thunderbikes/kicad_cntrl_board/img/hv.png

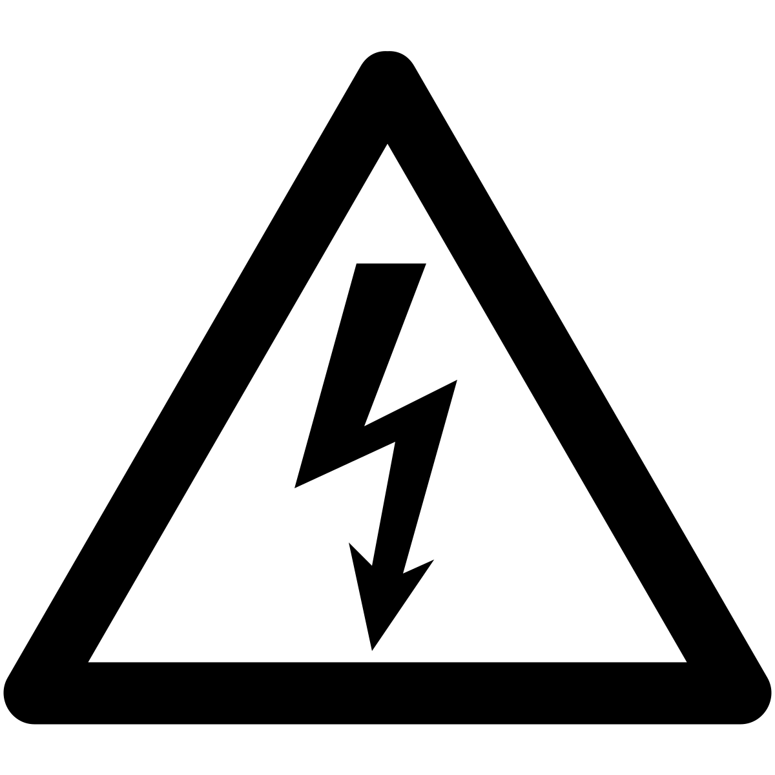
img/hv.png
