thunderbikes/kicad_cntrl_board/main_relay_board.kicad_pcb

## KiCad design main_relay_board.kicad_pcb (2024-07-14)

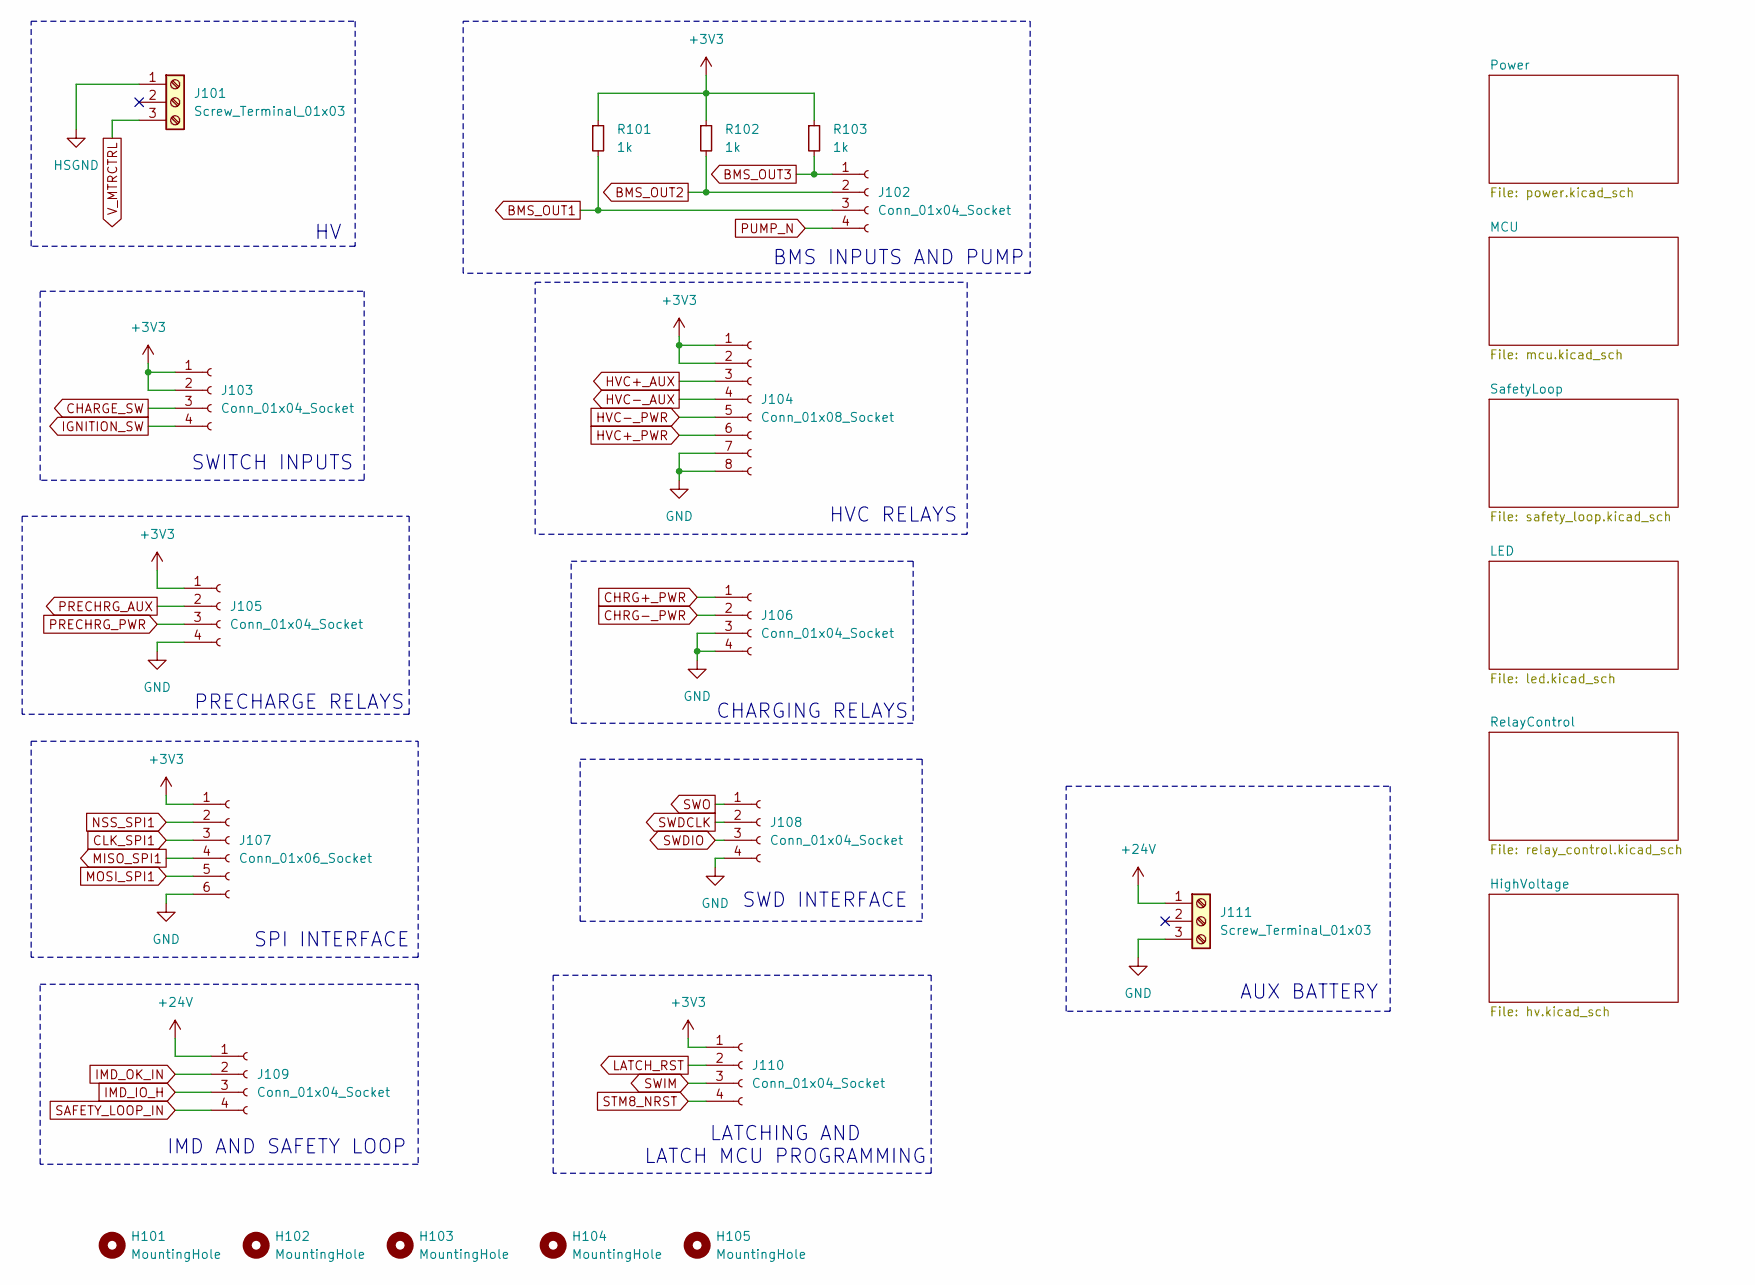
[picture p10: schematic main_relay_board.kicad_sch, Relay Control Board]

Parts:
H101, H102, H103, H104, H105: MountingHole; MountingHole_3mm
J101, J111: Screw_Terminal_01x03; TerminalBlock_Phoenix_MKDS-1,5-3-5.08_1x03_P5.08mm_Horizont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
J102, J103, J105, J106, J108, J109, J110: Conn_01x04_Socket; Molex_Mini-Fit_Jr_5566-04A_2x02_P4.20mm_Vertical
J104: Conn_01x08_Socket; Molex_Mini-Fit_Jr_5566-08A_2x04_P4.20mm_Vertical
J107: Conn_01x06_Socket; Molex_Mini-Fit_Jr_5566-06A_2x03_P4.20mm_Vertical
R101, R102, R103: 1k; R_0603_1608Metric; LCSC C22548

Connections:
+3V3: J103.1, J103.2, J104.1, J104.2, J105.1, J107.1, J110.1, R101.1, R102.1, R103.1; also elsewhere on the board
+24V: J109.1, J111.1; also elsewhere on the board
BMS_OUT1: J102.3, R101.2; also elsewhere on the board
BMS_OUT2: J102.2, R102.2; also elsewhere on the board
BMS_OUT3: J102.1, R103.2; also elsewhere on the board
CHARGE_SW: J103.3; also elsewhere on the board
CHRG+_PWR: J106.1; also elsewhere on the board
CHRG-_PWR: J106.2; also elsewhere on the board
CLK_SPI1: J107.3; also elsewhere on the board
GND: J104.7, J104.8, J105.4, J106.3, J106.4, J107.6, J108.4, J111.3; also elsewhere on the board
HSGND: J101.1; also elsewhere on the board
HVC+_AUX: J104.3; also elsewhere on the board
HVC+_PWR: J104.6; also elsewhere on the board
HVC-_AUX: J104.4; also elsewhere on the board
HVC-_PWR: J104.5; also elsewhere on the board
IGNITION_SW: J103.4; also elsewhere on the board
IMD_IO_H: J109.3; also elsewhere on the board
IMD_OK_IN: J109.2; also elsewhere on the board
LATCH_RST: J110.2; also elsewhere on the board
MISO_SPI1: J107.4; also elsewhere on the board
MOSI_SPI1: J107.5; also elsewhere on the board
NSS_SPI1: J107.2; also elsewhere on the board
PRECHRG_AUX: J105.2; also elsewhere on the board
PRECHRG_PWR: J105.3; also elsewhere on the board
PUMP_N: J102.4; also elsewhere on the board
SAFETY_LOOP_IN: J109.4; also elsewhere on the board
STM8_NRST: J110.4; also elsewhere on the board
SWDCLK: J108.2; also elsewhere on the board
SWDIO: J108.3; also elsewhere on the board
SWIM: J110.3; also elsewhere on the board
SWO: J108.1; also elsewhere on the board
V_MTRCTRL: J101.3; also elsewhere on the board

Notes on the sheet:
PRECHARGE RELAYS
BMS INPUTS AND PUMP
AUX BATTERY
CHARGING RELAYS
IMD AND SAFETY LOOP
SWD INTERFACE
SWITCH INPUTS
SPI INTERFACE
LATCHING AND LATCH MCU PROGRAMMING
HVC RELAYS

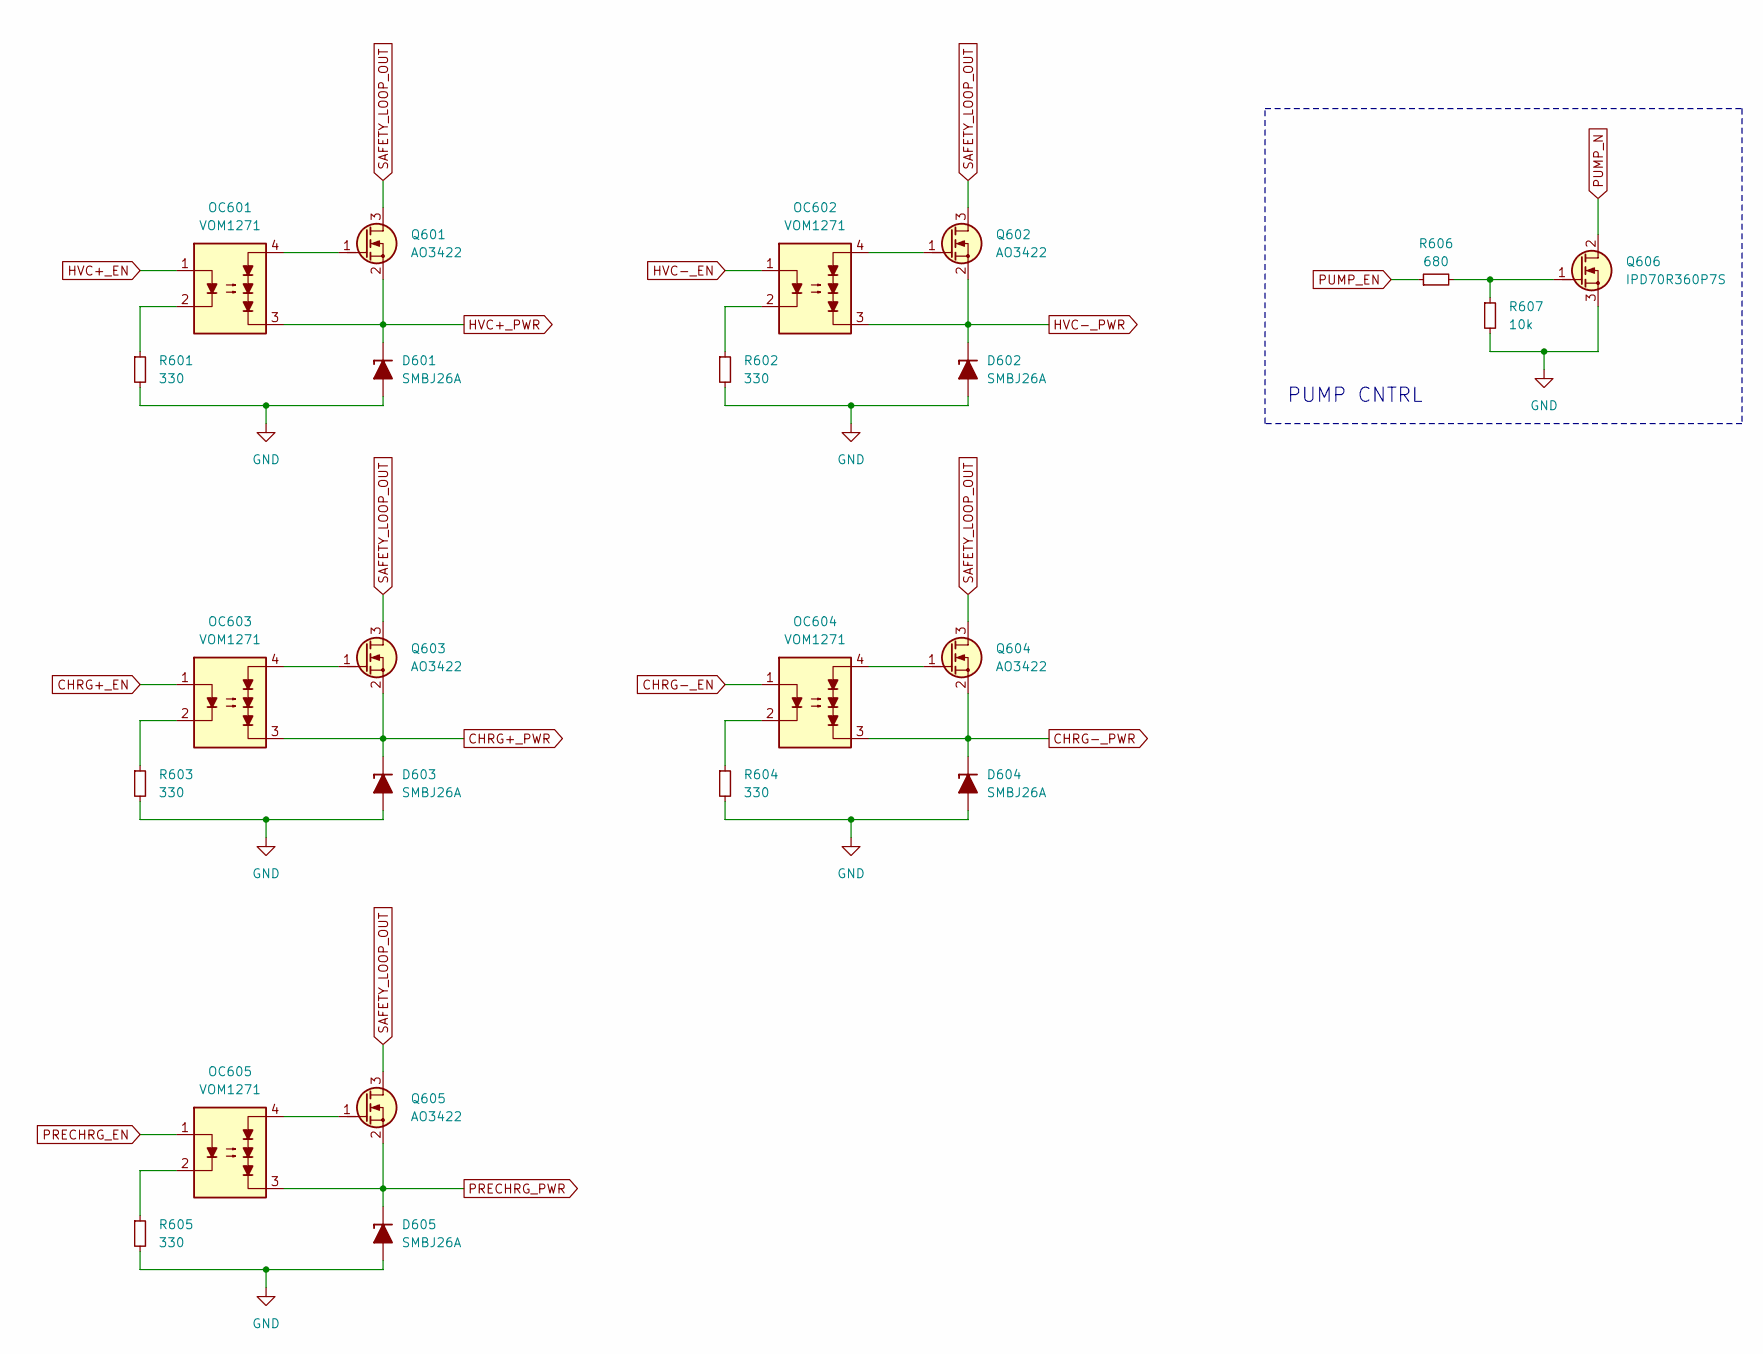
[picture p11: schematic relay_control.kicad_sch, Relay Control Board]

Parts:
D601, D602, D603, D604, D605: SMBJ26A; D_SMB; LCSC C2918418
OC601, OC602, OC603, OC604, OC605: VOM1271; SOIC254P695X242-4N; LCSC C146286
Q601, Q602, Q603, Q604, Q605: AO3422; SOT-23; LCSC C37130
Q606: IPD70R360P7S; TO-252-2; LCSC C151509
R601, R602, R603, R604, R605: 330; R_0603_1608Metric; LCSC C25804
R606: 680; R_0603_1608Metric; LCSC C23228
R607: 10k; R_0603_1608Metric; LCSC C25804

Connections:
CHRG+_EN: OC603.1; also elsewhere on the board
CHRG+_PWR: D603.1 (K), OC603.3, Q603.2 (S); also elsewhere on the board
CHRG-_EN: OC604.1; also elsewhere on the board
CHRG-_PWR: D604.1 (K), OC604.3, Q604.2 (S); also elsewhere on the board
GND: D601.2 (A), D602.2 (A), D603.2 (A), D604.2 (A), D605.2 (A), Q606.3 (S), R601.2, R602.2, R603.2, R604.2, R605.2, R607.2; also elsewhere on the board
HVC+_EN: OC601.1; also elsewhere on the board
HVC+_PWR: D601.1 (K), OC601.3, Q601.2 (S); also elsewhere on the board
HVC-_EN: OC602.1; also elsewhere on the board
HVC-_PWR: D602.1 (K), OC602.3, Q602.2 (S); also elsewhere on the board
unnamed: OC601.2, R601.1
unnamed: OC602.2, R602.1
unnamed: OC603.2, R603.1
unnamed: OC604.2, R604.1
unnamed: OC605.2, R605.1
unnamed: OC601.4, Q601.1 (G)
unnamed: OC602.4, Q602.1 (G)
unnamed: OC603.4, Q603.1 (G)
unnamed: OC604.4, Q604.1 (G)
unnamed: OC605.4, Q605.1 (G)
unnamed: Q606.1 (G), R606.2, R607.1
PRECHRG_EN: OC605.1; also elsewhere on the board
PRECHRG_PWR: D605.1 (K), OC605.3, Q605.2 (S); also elsewhere on the board
PUMP_EN: R606.1; also elsewhere on the board
PUMP_N: Q606.2 (D); also elsewhere on the board
SAFETY_LOOP_OUT: Q601.3 (D), Q602.3 (D), Q603.3 (D), Q604.3 (D), Q605.3 (D); also elsewhere on the board

Notes on the sheet:
PUMP CNTRL

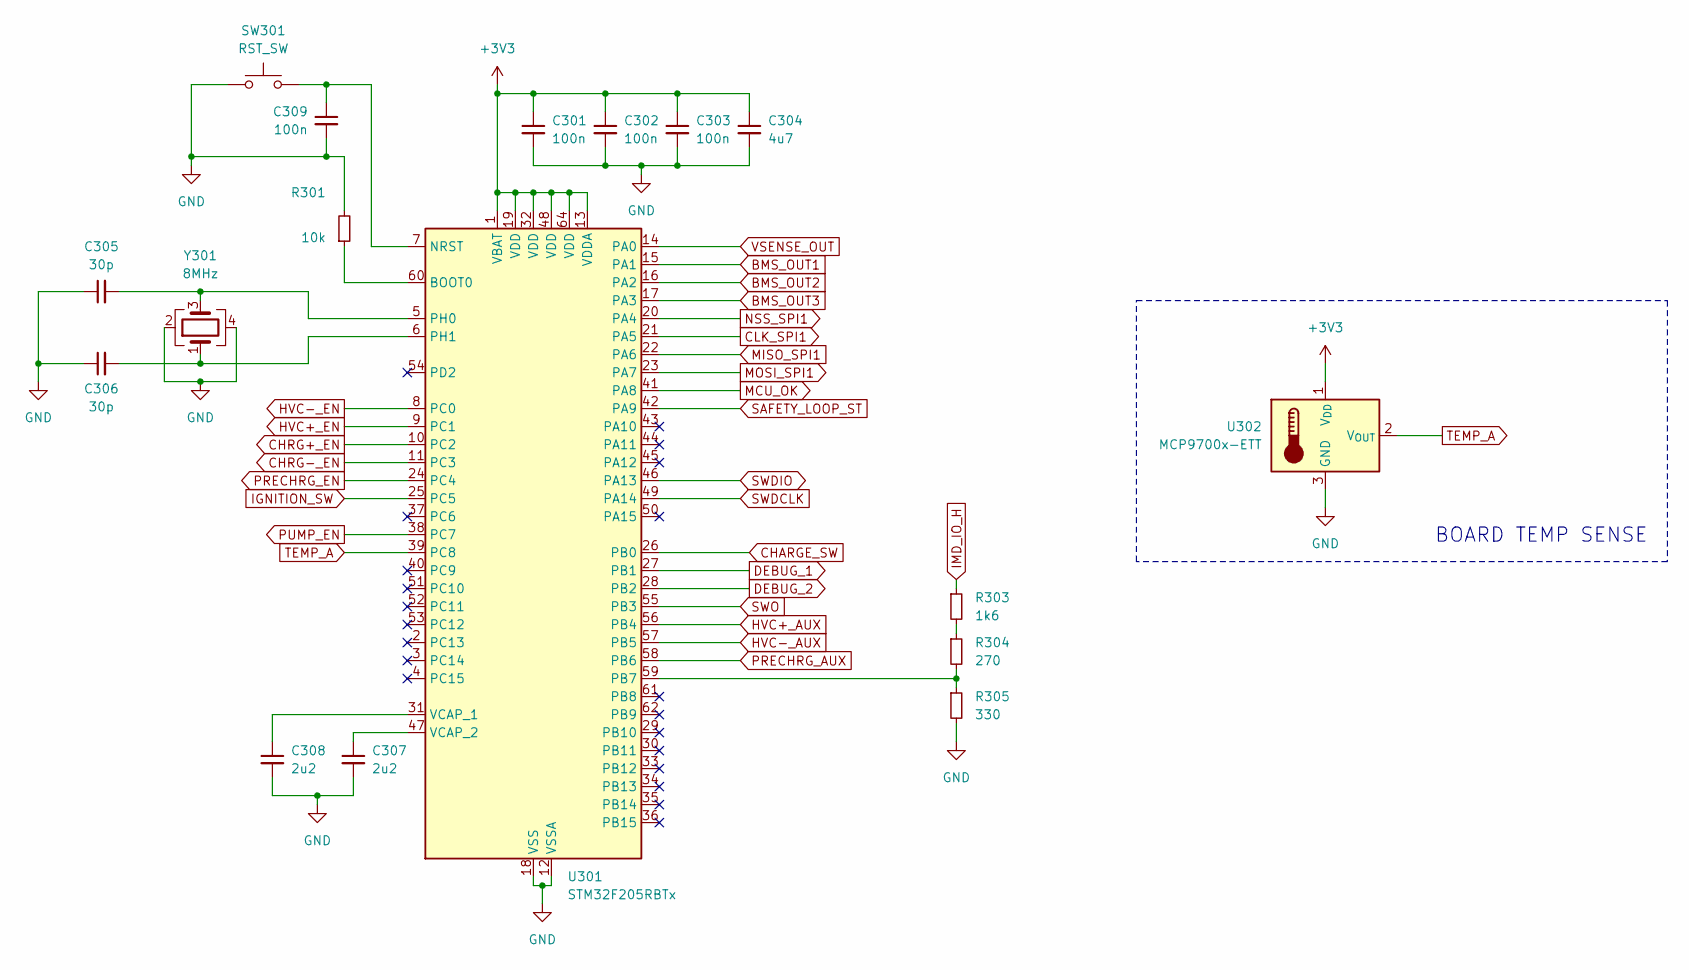
[picture p12: schematic mcu.kicad_sch, Relay Control Board]

Parts:
C301, C302, C303, C309: 100n; C_0603_1608Metric; LCSC C1591
C304: 4u7; C_0603_1608Metric; LCSC C108342
C305, C306: 30p; C_0603_1608Metric; LCSC C1853723
C307, C308: 2u2; C_0603_1608Metric; LCSC C99228
R301: 10k; R_0603_1608Metric; LCSC C25804
R303: 1k6; R_0603_1608Metric; LCSC C22847
R304: 270; R_0603_1608Metric; LCSC C22966
R305: 330; R_0603_1608Metric; LCSC C105881
SW301: RST_SW; SW_Tactile_SPST_NO_Straight_CK_PTS636Sx25SMTRLFS; LCSC C318938
U301: STM32F205RBTx; LQFP-64_10x10mm_P0.5mm; LCSC C8364
U302: MCP9700x-ETT; SOT-23; LCSC C127949
Y301: 8MHz; Crystal_SMD_3225-4Pin_3.2x2.5mm; LCSC C2682775

Connections:
+3V3: C301.1, C302.1, C303.1, C304.1, U301.1 (VBAT), U301.13 (VDDA), U301.19 (VDD), U301.32 (VDD), U301.48 (VDD), U301.64 (VDD), U302.1 (V_{DD}); also elsewhere on the board
BMS_OUT1: U301.15 (PA1); also elsewhere on the board
BMS_OUT2: U301.16 (PA2); also elsewhere on the board
BMS_OUT3: U301.17 (PA3); also elsewhere on the board
CHARGE_SW: U301.26 (PB0); also elsewhere on the board
CHRG+_EN: U301.10 (PC2); also elsewhere on the board
CHRG-_EN: U301.11 (PC3); also elsewhere on the board
CLK_SPI1: U301.21 (PA5); also elsewhere on the board
DEBUG_1: U301.27 (PB1); also elsewhere on the board
DEBUG_2: U301.28 (PB2); also elsewhere on the board
GND: C301.2, C302.2, C303.2, C304.2, C305.1, C306.1, C307.2, C308.2, C309.2, R301.2, R305.2, SW301.1, U301.12 (VSSA), U301.18 (VSS), U301.63 (VSS), U302.3 (GND), Y301.2, Y301.4; also elsewhere on the board
HVC+_AUX: U301.56 (PB4); also elsewhere on the board
HVC+_EN: U301.9 (PC1); also elsewhere on the board
HVC-_AUX: U301.57 (PB5); also elsewhere on the board
HVC-_EN: U301.8 (PC0); also elsewhere on the board
IGNITION_SW: U301.25 (PC5); also elsewhere on the board
IMD_IO_H: R303.1; also elsewhere on the board
MCU_OK: U301.41 (PA8); also elsewhere on the board
MISO_SPI1: U301.22 (PA6); also elsewhere on the board
MOSI_SPI1: U301.23 (PA7); also elsewhere on the board
NSS_SPI1: U301.20 (PA4); also elsewhere on the board
unnamed: R303.2, R304.1
unnamed: R301.1, U301.60 (BOOT0)
unnamed: C309.1, SW301.2, U301.7 (NRST)
unnamed: R304.2, R305.1, U301.59 (PB7)
unnamed: C305.2, U301.5 (PH0), Y301.3
unnamed: C306.2, U301.6 (PH1), Y301.1
unnamed: C308.1, U301.31 (VCAP_1)
unnamed: C307.1, U301.47 (VCAP_2)
PRECHRG_AUX: U301.58 (PB6); also elsewhere on the board
PRECHRG_EN: U301.24 (PC4); also elsewhere on the board
PUMP_EN: U301.38 (PC7); also elsewhere on the board
SAFETY_LOOP_ST: U301.42 (PA9); also elsewhere on the board
SWDCLK: U301.49 (PA14); also elsewhere on the board
SWDIO: U301.46 (PA13); also elsewhere on the board
SWO: U301.55 (PB3); also elsewhere on the board
TEMP_A: U301.39 (PC8), U302.2 (V_{OUT})
VSENSE_OUT: U301.14 (PA0); also elsewhere on the board

Notes on the sheet:
BOARD TEMP SENSE

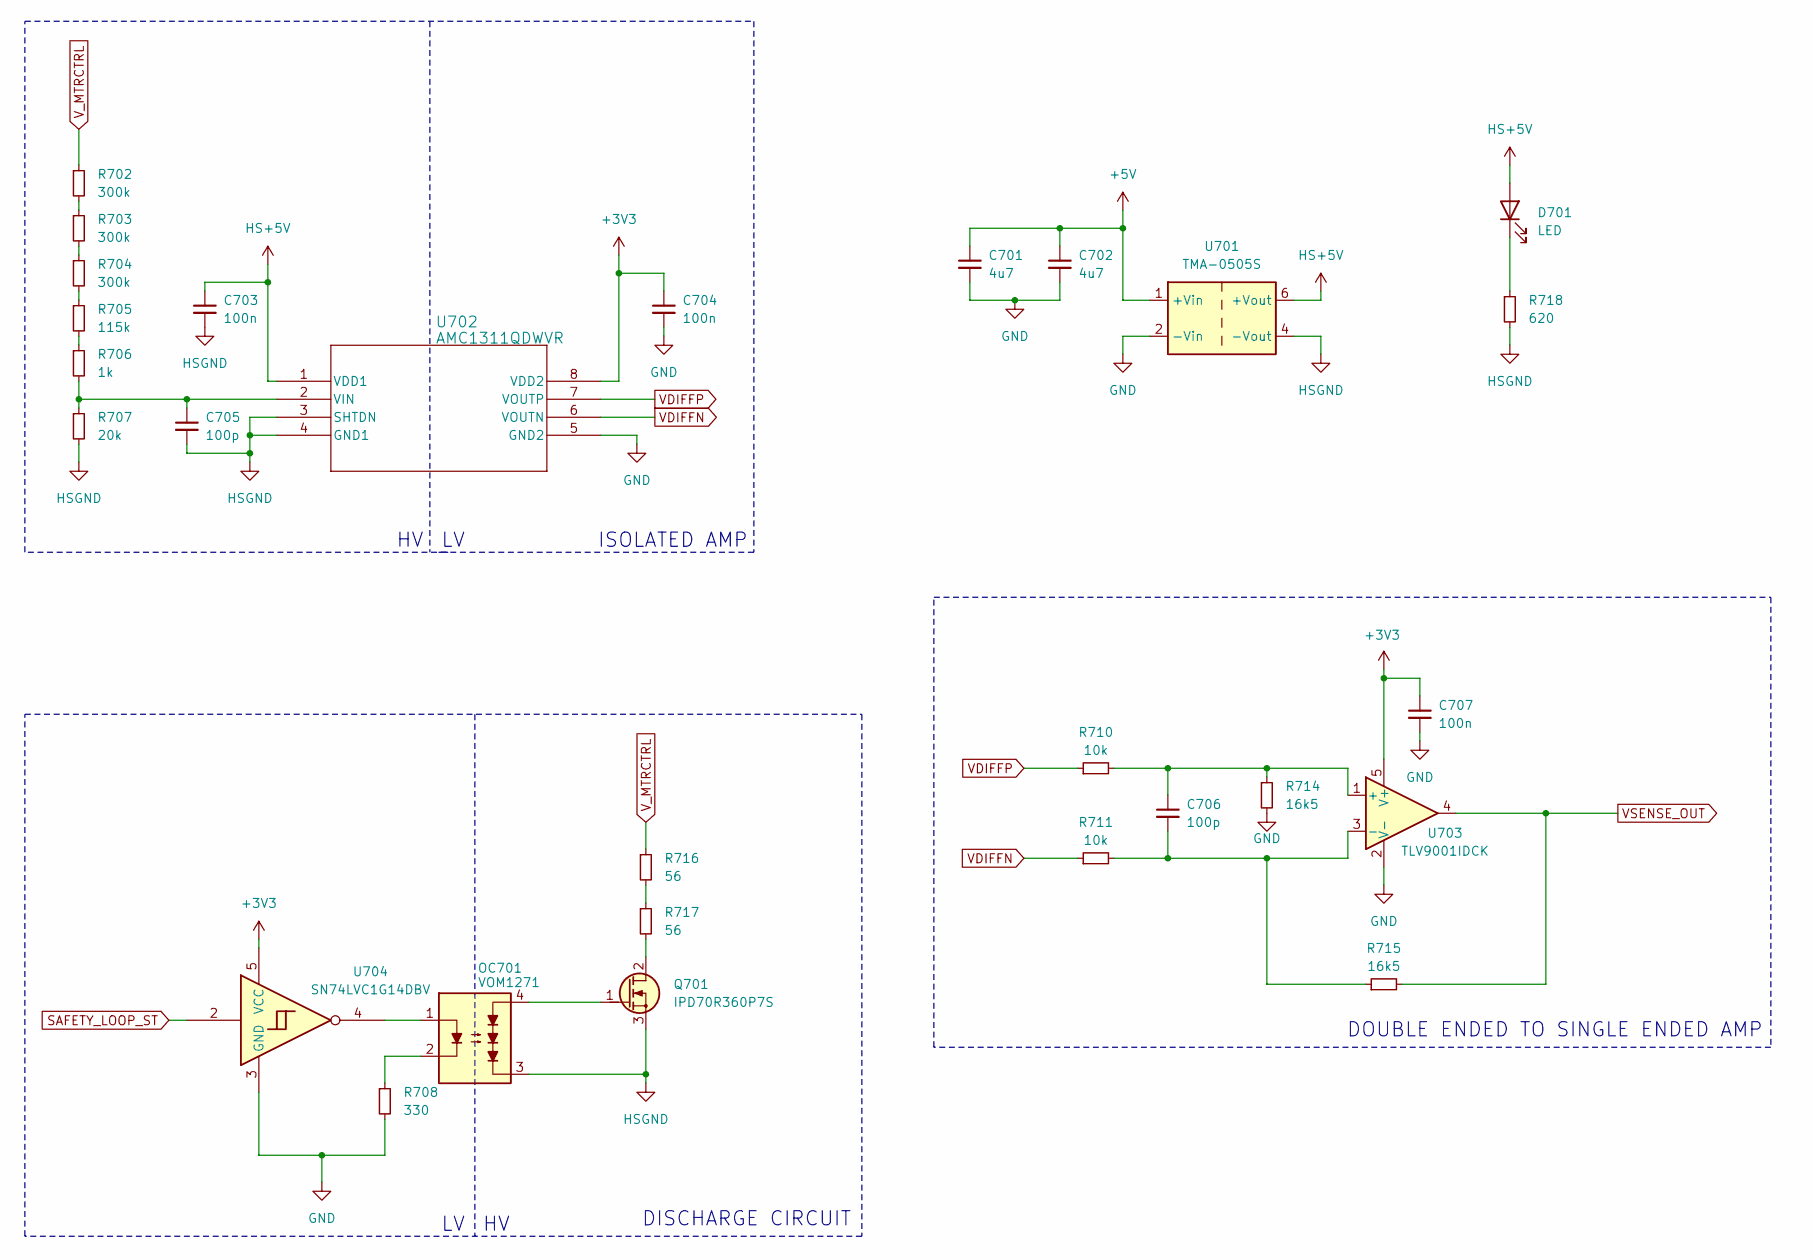
[picture p13: schematic hv.kicad_sch, Relay Control Board]

Parts:
C701, C702: 4u7; C_0603_1608Metric; LCSC C108342
C703, C704, C707: 100n; C_0603_1608Metric; LCSC C1591
C705, C706: 100p; C_0603_1608Metric; LCSC C160903
D701: LED; LED_0603_1608Metric; LCSC C84263
OC701: VOM1271; SOIC254P695X242-4N; LCSC C146286
Q701: IPD70R360P7S; TO-252-2; LCSC C151509
R702, R703, R704: 300k; R_0603_1608Metric; LCSC C23024
R705: 115k; R_0603_1608Metric; LCSC C3016434
R706: 1k; R_0603_1608Metric; LCSC C22548
R707: 20k; R_0603_1608Metric; LCSC C4184
R708: 330; R_0603_1608Metric; LCSC C105881
R710, R711: 10k; R_0603_1608Metric; LCSC C25804
R714, R715: 16k5; R_0603_1608Metric; LCSC C2933155
R716, R717: 56; TO-247-2_Vertical; DigiKey 273-AP10156RF-ND
R718: 620; R_0603_1608Metric; LCSC C23220
U701: TMA-0505S; Converter_DCDC_TRACO_TMA-05xxS_12xxS_Single_THT; DigiKey 1951-1003-ND
U702: AMC1311QDWVR; DWV8_TEX; LCSC C456277
U703: TLV9001IDCK; SOT-353_SC-70-5; LCSC C398362
U704: SN74LVC1G14DBV; SOT-23-5; LCSC C434069

Connections:
+3V3: C704.1, C707.1, U702.8 (VDD2), U703.5 (V+), U704.5 (VCC); also elsewhere on the board
+5V: C701.1, C702.1, U701.1 (+Vin); also elsewhere on the board
GND: C701.2, C702.2, C704.2, C707.2, R708.2, R714.2, U701.2 (-Vin), U702.5 (GND2), U703.2 (V-), U704.3 (GND); also elsewhere on the board
HS+5V: C703.1, D701.2 (A), U701.6 (+Vout), U702.1 (VDD1)
HSGND: C703.2, C705.2, OC701.3, Q701.3 (S), R707.2, R718.2, U701.4 (-Vout), U702.3 (SHTDN), U702.4 (GND1); also elsewhere on the board
unnamed: D701.1 (K), R718.1
unnamed: OC701.1, U704.4
unnamed: OC701.2, R708.1
unnamed: Q701.2 (D), R717.2
unnamed: OC701.4, Q701.1 (G)
unnamed: R702.2, R703.1
unnamed: R703.2, R704.1
unnamed: R704.2, R705.1
unnamed: R705.2, R706.1
unnamed: R716.2, R717.1
unnamed: C705.1, R706.2, R707.1, U702.2 (VIN)
unnamed: C706.1, R710.2, R714.1, U703.1 (+)
unnamed: C706.2, R711.2, R715.1, U703.3 (-)
SAFETY_LOOP_ST: U704.2; also elsewhere on the board
VDIFFN: R711.1, U702.6 (VOUTN)
VDIFFP: R710.1, U702.7 (VOUTP)
VSENSE_OUT: R715.2, U703.4; also elsewhere on the board
V_MTRCTRL: R702.1, R716.1; also elsewhere on the board

Notes on the sheet:
DISCHARGE CIRCUIT
ISOLATED AMP
DOUBLE ENDED TO SINGLE ENDED AMP

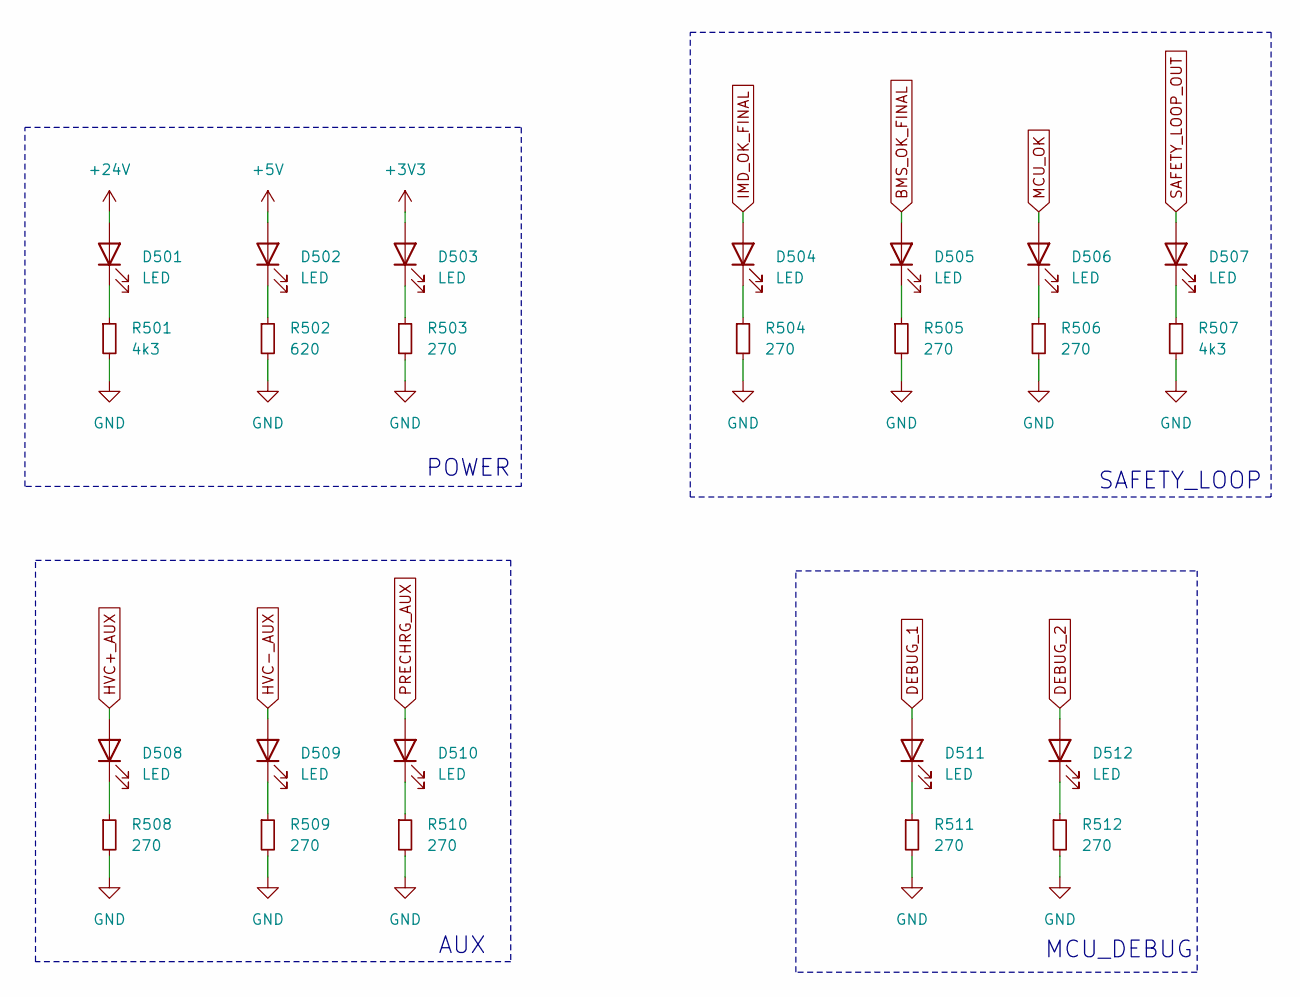
[picture p14: schematic led.kicad_sch, Relay Control Board]

Parts:
D501, D502, D503, D504, D505, D506, D507, D508, D509, D510, D511, D512: LED; LED_0603_1608Metric; LCSC C84263
R501, R507: 4k3; R_0603_1608Metric; LCSC C23159
R502: 620; R_0603_1608Metric; LCSC C23220
R503, R504, R505, R506, R508, R509, R510, R511, R512: 270; R_0603_1608Metric; LCSC C22966

Connections:
+3V3: D503.2 (A); also elsewhere on the board
+5V: D502.2 (A); also elsewhere on the board
+24V: D501.2 (A); also elsewhere on the board
BMS_OK_FINAL: D505.2 (A); also elsewhere on the board
DEBUG_1: D511.2 (A); also elsewhere on the board
DEBUG_2: D512.2 (A); also elsewhere on the board
GND: R501.2, R502.2, R503.2, R504.2, R505.2, R506.2, R507.2, R508.2, R509.2, R510.2, R511.2, R512.2; also elsewhere on the board
HVC+_AUX: D508.2 (A); also elsewhere on the board
HVC-_AUX: D509.2 (A); also elsewhere on the board
IMD_OK_FINAL: D504.2 (A); also elsewhere on the board
MCU_OK: D506.2 (A); also elsewhere on the board
unnamed: D501.1 (K), R501.1
unnamed: D502.1 (K), R502.1
unnamed: D503.1 (K), R503.1
unnamed: D504.1 (K), R504.1
unnamed: D505.1 (K), R505.1
unnamed: D506.1 (K), R506.1
unnamed: D507.1 (K), R507.1
unnamed: D508.1 (K), R508.1
unnamed: D509.1 (K), R509.1
unnamed: D510.1 (K), R510.1
unnamed: D511.1 (K), R511.1
unnamed: D512.1 (K), R512.1
PRECHRG_AUX: D510.2 (A); also elsewhere on the board
SAFETY_LOOP_OUT: D507.2 (A); also elsewhere on the board

Notes on the sheet:
SAFETY_LOOP
MCU_DEBUG
POWER
AUX

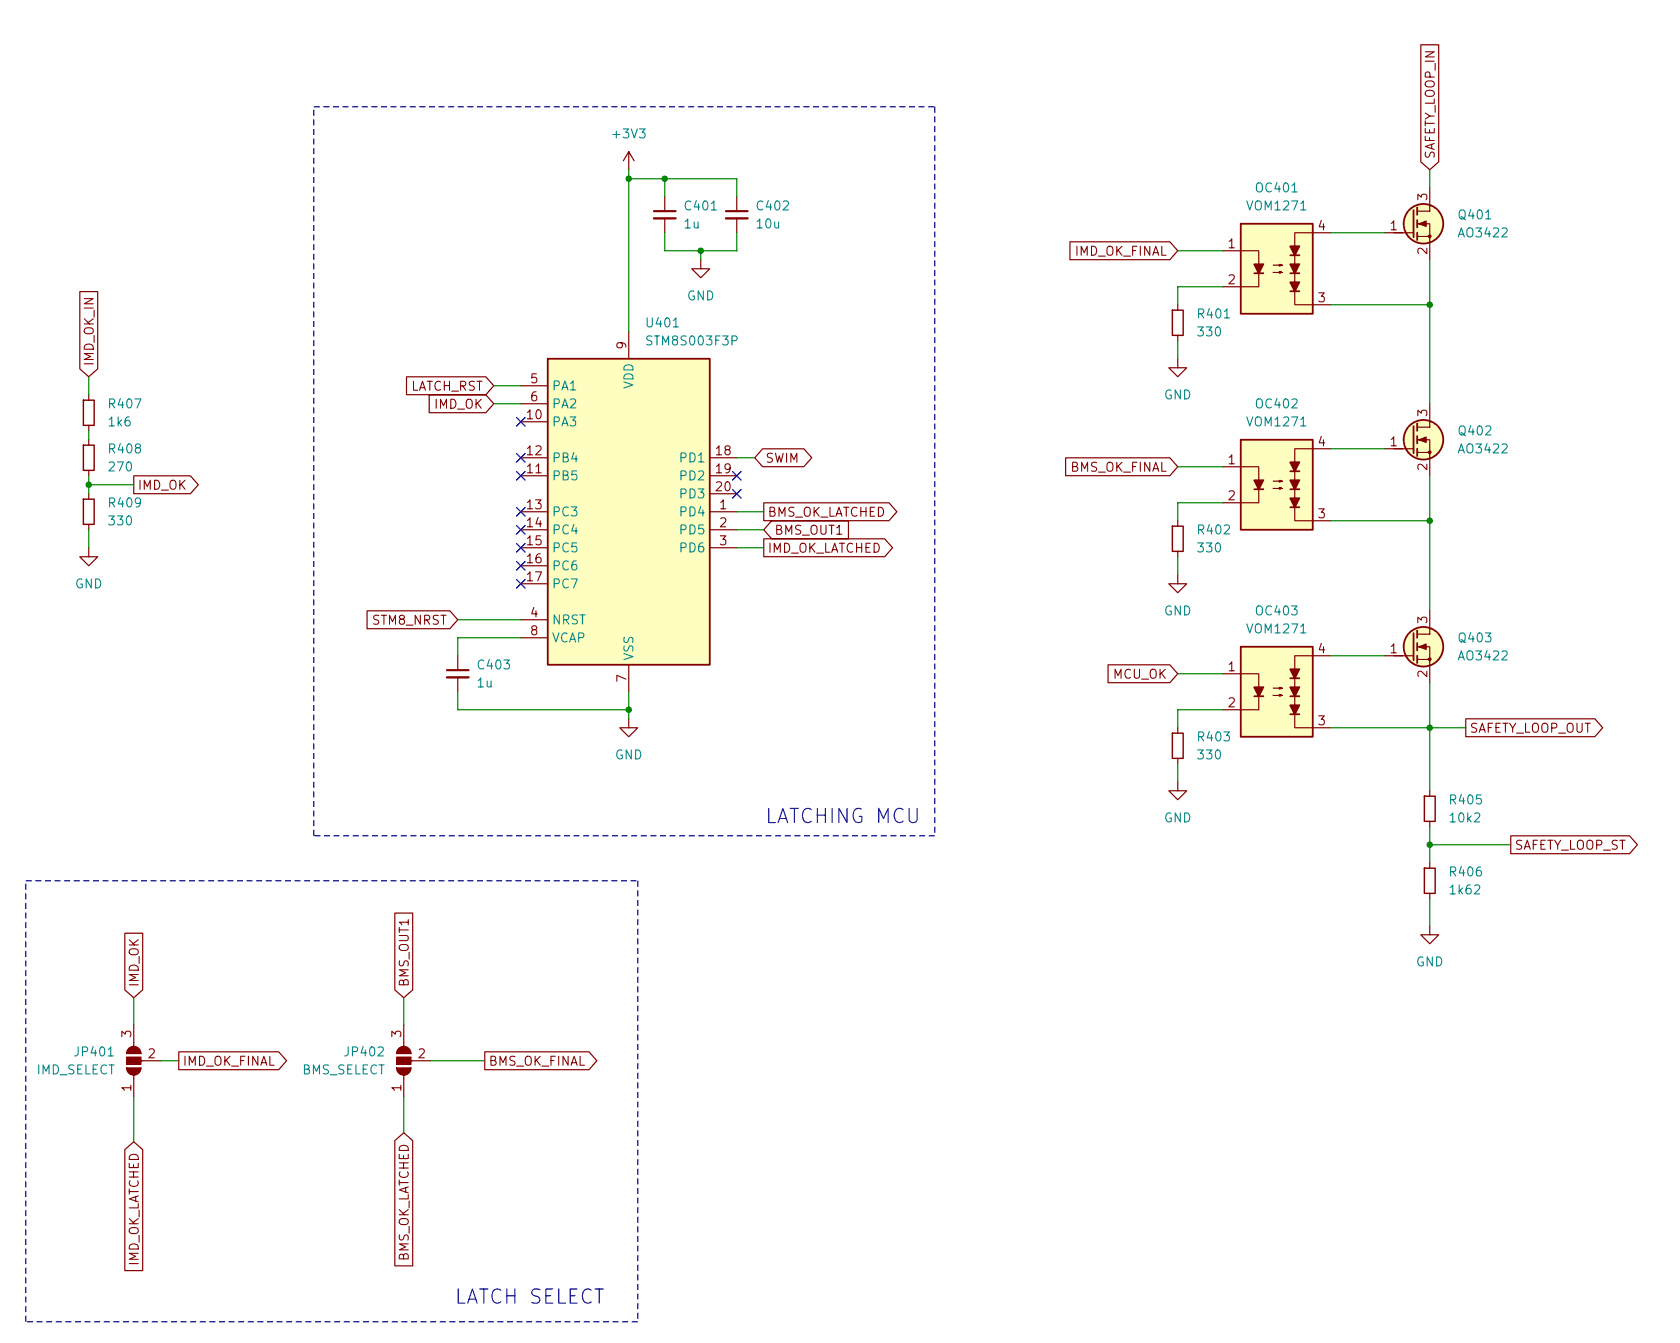
[picture p15: schematic safety_loop.kicad_sch, Relay Control Board]

Parts:
C401, C403: 1u; C_0603_1608Metric; LCSC C59302
C402: 10u; C_0603_1608Metric; LCSC C91606
JP401: IMD_SELECT; SolderJumper-3_P1.3mm_Open_Pad1.0x1.5mm
JP402: BMS_SELECT; SolderJumper-3_P1.3mm_Open_Pad1.0x1.5mm
OC401, OC402, OC403: VOM1271; SOIC254P695X242-4N; LCSC C146286
Q401, Q402, Q403: AO3422; SOT-23; LCSC C37130
R401, R402, R403, R409: 330; R_0603_1608Metric; LCSC C105881
R405: 10k2; R_0603_1608Metric; LCSC C22772
R406: 1k62; R_0603_1608Metric; LCSC C22844
R407: 1k6; R_0603_1608Metric; LCSC C22847
R408: 270; R_0603_1608Metric; LCSC C22966
U401: STM8S003F3P; TSSOP-20_4.4x6.5mm_P0.65mm; LCSC C52717

Connections:
+3V3: C401.1, C402.1, U401.9 (VDD); also elsewhere on the board
BMS_OK_FINAL: JP402.2 (C), OC402.1; also elsewhere on the board
BMS_OK_LATCHED: JP402.1 (A), U401.1 (PD4)
BMS_OUT1: JP402.3 (B), U401.2 (PD5); also elsewhere on the board
GND: C401.2, C402.2, C403.2, R401.2, R402.2, R403.2, R406.2, R409.2, U401.7 (VSS); also elsewhere on the board
IMD_OK: JP401.3 (B), R408.2, R409.1, U401.6 (PA2)
IMD_OK_FINAL: JP401.2 (C), OC401.1; also elsewhere on the board
IMD_OK_IN: R407.1; also elsewhere on the board
IMD_OK_LATCHED: JP401.1 (A), U401.3 (PD6)
LATCH_RST: U401.5 (PA1); also elsewhere on the board
MCU_OK: OC403.1; also elsewhere on the board
unnamed: OC401.2, R401.1
unnamed: OC402.2, R402.1
unnamed: OC403.2, R403.1
unnamed: OC401.4, Q401.1 (G)
unnamed: OC401.3, Q401.2 (S), Q402.3 (D)
unnamed: OC402.4, Q402.1 (G)
unnamed: OC402.3, Q402.2 (S), Q403.3 (D)
unnamed: OC403.4, Q403.1 (G)
unnamed: R407.2, R408.1
unnamed: C403.1, U401.8 (VCAP)
SAFETY_LOOP_IN: Q401.3 (D); also elsewhere on the board
SAFETY_LOOP_OUT: OC403.3, Q403.2 (S), R405.1; also elsewhere on the board
SAFETY_LOOP_ST: R405.2, R406.1; also elsewhere on the board
STM8_NRST: U401.4 (NRST); also elsewhere on the board
SWIM: U401.18 (PD1); also elsewhere on the board

Notes on the sheet:
LATCHING MCU
LATCH SELECT

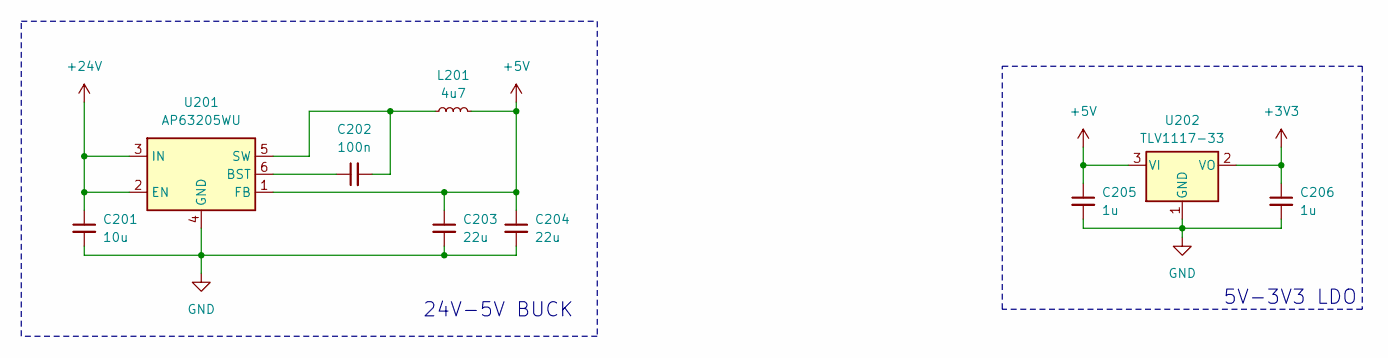
[picture p16: schematic power.kicad_sch, Relay Control Board]

Parts:
C201: 10u; C_0603_1608Metric; LCSC C91606
C202: 100n; C_0603_1608Metric; LCSC C1591
C203, C204: 22u; C_0603_1608Metric; LCSC C86295
C205, C206: 1u; C_0603_1608Metric; LCSC C59302
L201: 4u7; L_1210_3225Metric; LCSC C2045343
U201: AP63205WU; TSOT-23-6; LCSC C2071056
U202: TLV1117-33; SOT-223-3_TabPin2; LCSC C37359

Connections:
+3V3: C206.1, U202.2 (VO); also elsewhere on the board
+5V: C203.1, C204.1, C205.1, L201.2, U201.1 (FB), U202.3 (VI); also elsewhere on the board
+24V: C201.1, U201.2 (EN), U201.3 (IN); also elsewhere on the board
GND: C201.2, C203.2, C204.2, C205.2, C206.2, U201.4 (GND), U202.1 (GND); also elsewhere on the board
unnamed: C202.1, U201.6 (BST)
unnamed: C202.2, L201.1, U201.5 (SW)

Notes on the sheet:
5V-3V3 LDO
24V-5V BUCK

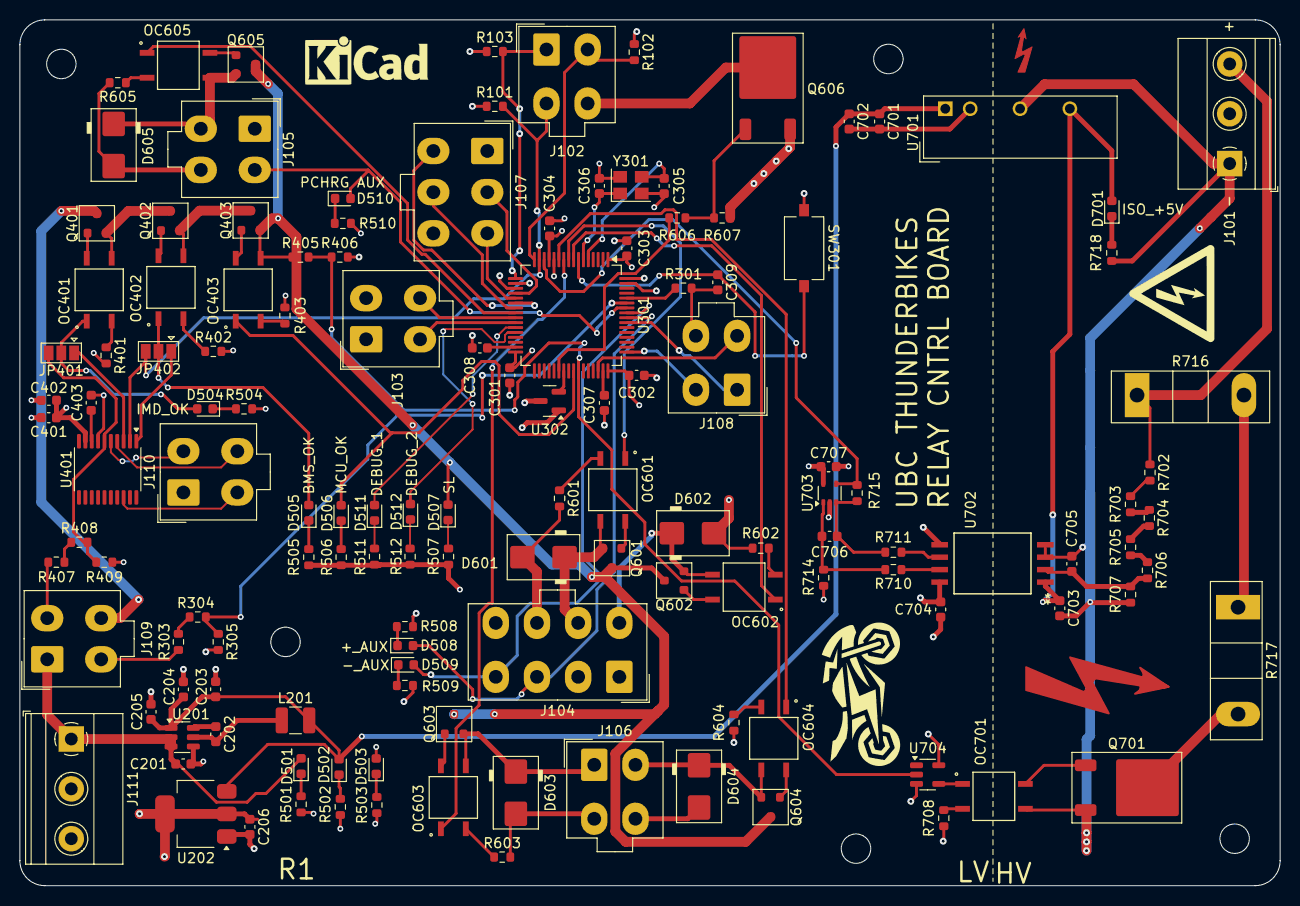
[picture p17: board main_relay_board.kicad_pcb from above]

Board: 4 copper layers, 128.5 x 88.3 mm, 140 parts (0 on the bottom side), 110 nets.
