thunderbikes/kicad_cntrl_board/(commit log)

2024-07-09 existing board with old HV buck
    [hv.kicad_sch, led.kicad_sch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]
2024-07-09 started working on it
    [hv.kicad_sch]
2024-07-11 switched to an isolated dcdc transformer from LS 5V
    [hv.kicad_sch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]
